usrataqila/microaqilausrat/resources/aqifuseholder.jpeg

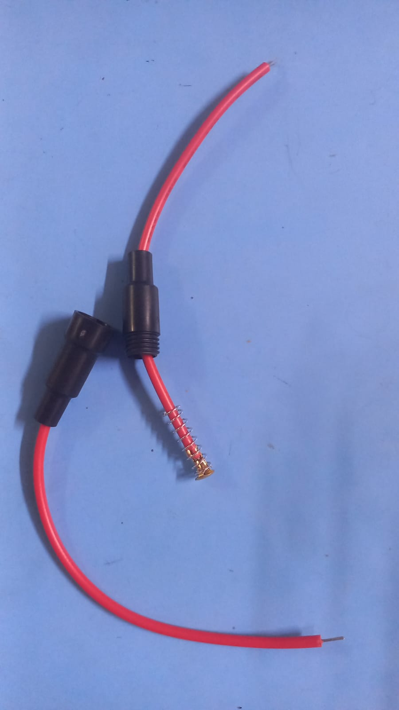
resources/aqifuseholder.jpeg
