usrataqila/microaqilausrat/resources/oled2.jpeg

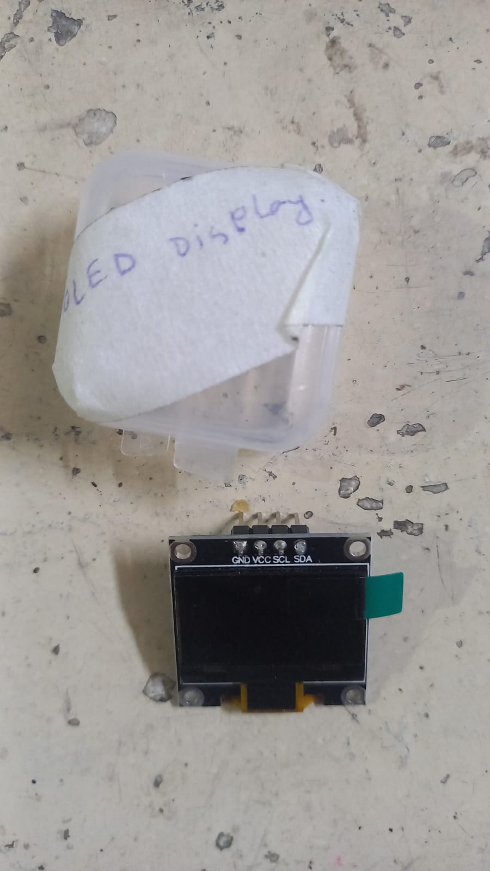
resources/oled2.jpeg
