usrataqila/microaqilausrat/README.md

# microaqilausrat

Project workspace.

> Placeholder README — replace once the project files are added.
