usrataqila/microaqilausrat/resources/adapter.jpeg

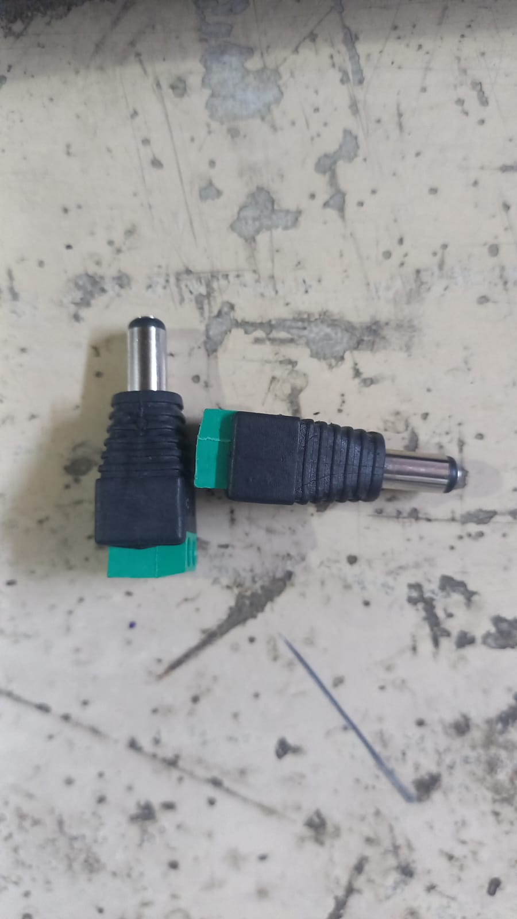
resources/adapter.jpeg
