usrataqila/microaqilausrat/resources/aqiceramicresistor.jpeg

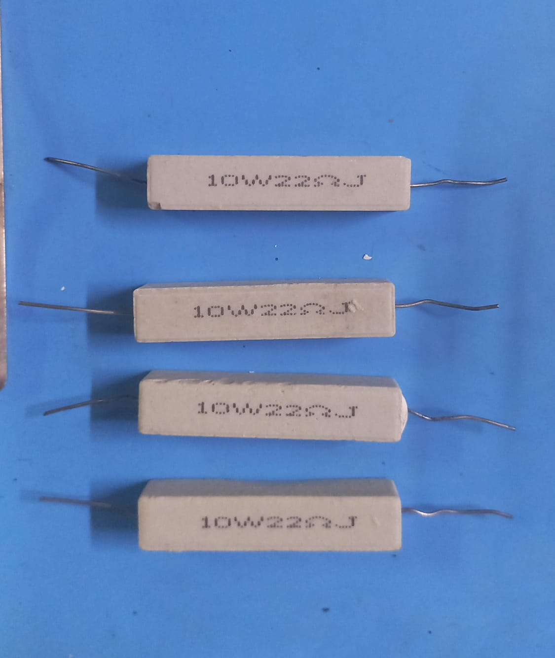
resources/aqiceramicresistor.jpeg
