usrataqila/microaqilausrat/resources/aqifuse.jpeg

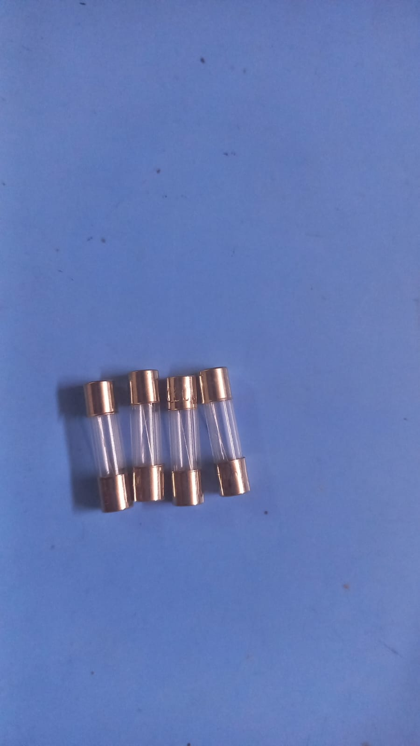
resources/aqifuse.jpeg
