usrataqila/microaqilausrat/resources/aqijackmaleandfemale2.jpeg

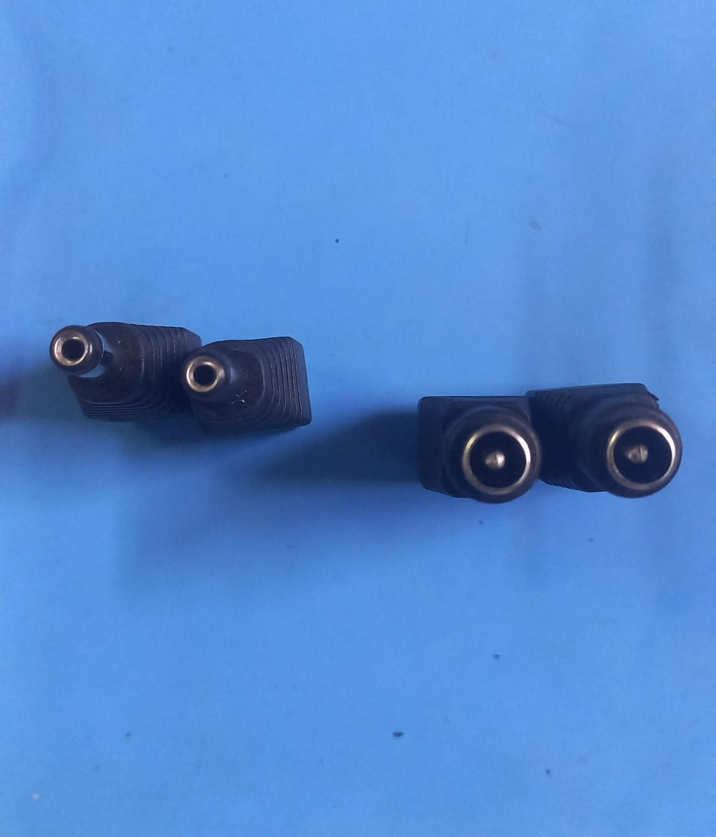
resources/aqijackmaleandfemale2.jpeg
