usrataqila/microaqilausrat/resources/aqijackmaleandfemale.jpeg

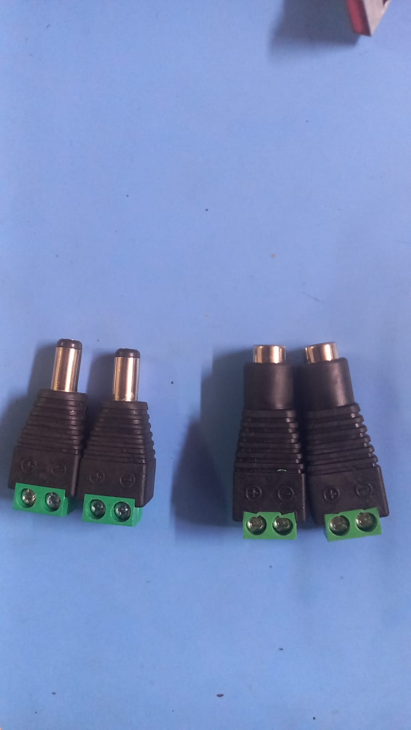
resources/aqijackmaleandfemale.jpeg
