usrataqila/microaqilausrat/resources/aqimultimeter.jpeg

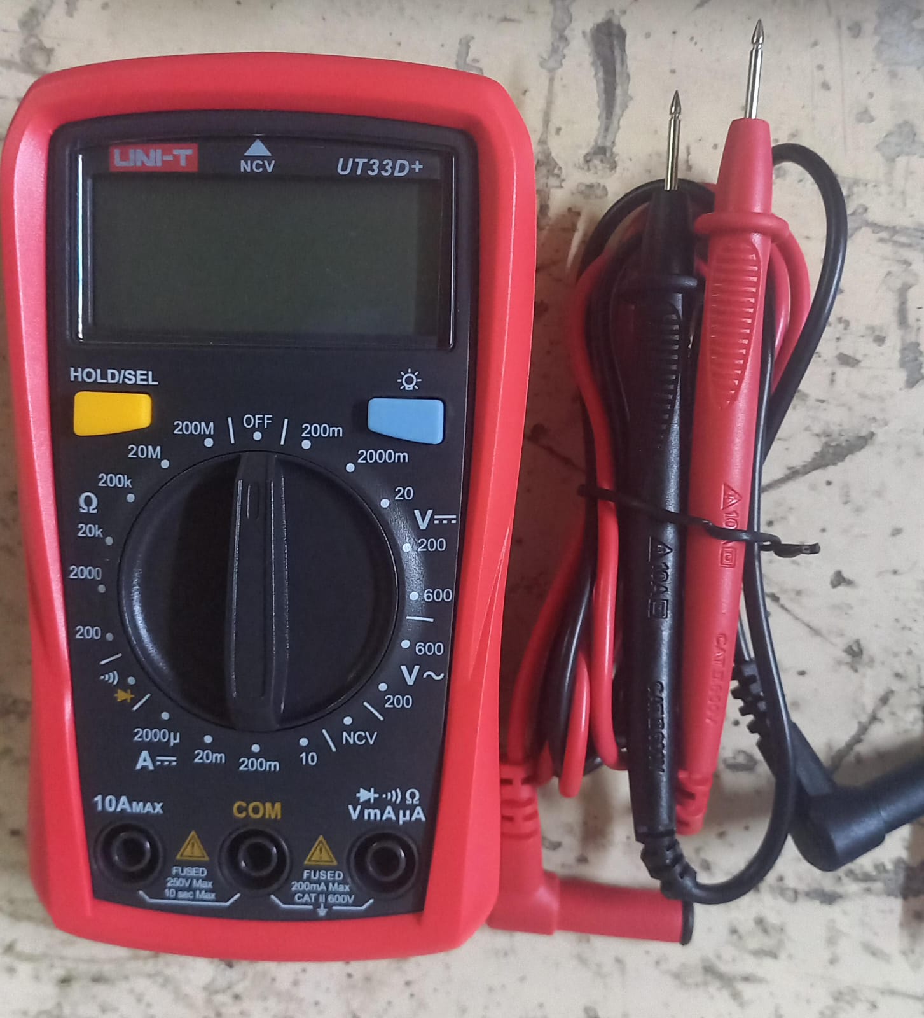
resources/aqimultimeter.jpeg
