usrataqila/microaqilausrat/resources/aqithermalswitch.jpeg

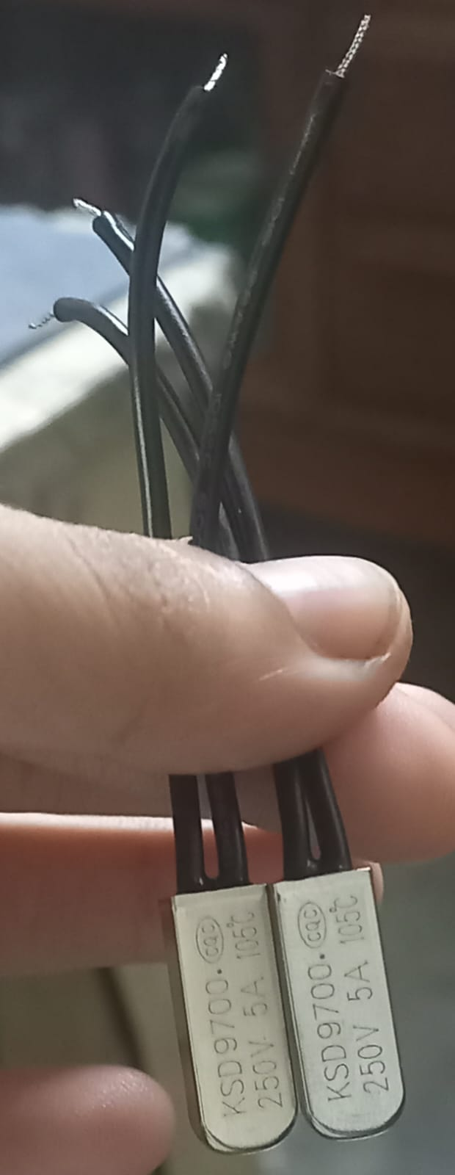
resources/aqithermalswitch.jpeg
