usrataqila/microaqilausrat/resources/aqiwire.jpeg

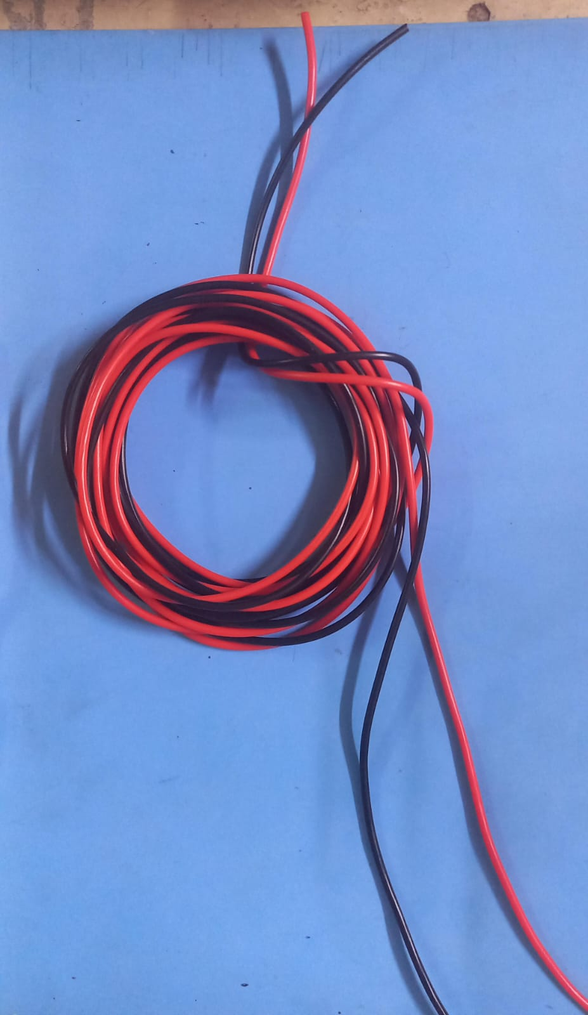
resources/aqiwire.jpeg
