usrataqila/microaqilausrat/resources/breadboard.jpeg

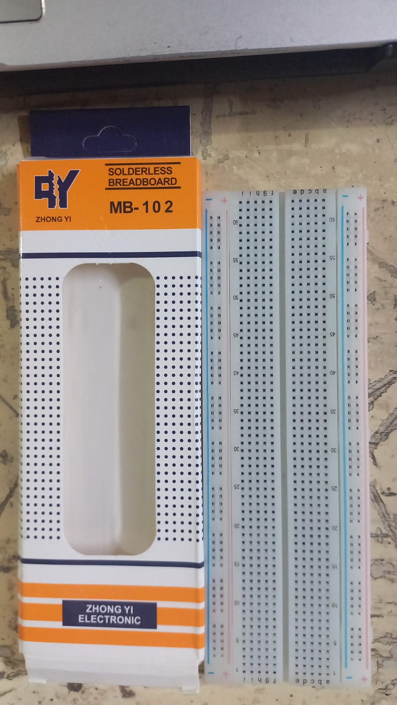
resources/breadboard.jpeg
