usrataqila/microaqilausrat/resources/esp2.jpeg

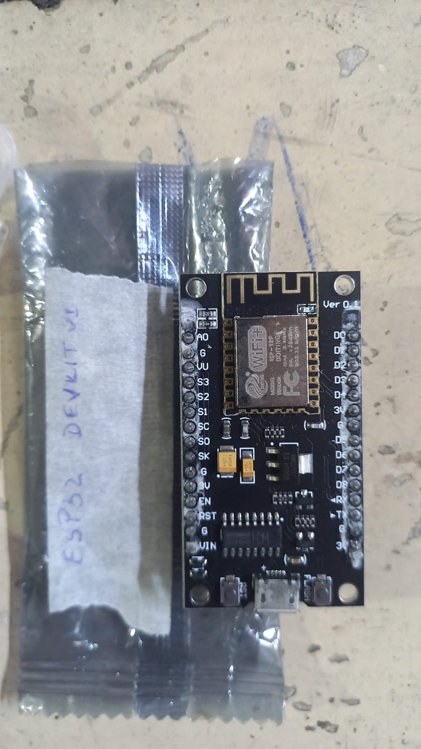
resources/esp2.jpeg
