usrataqila/microaqilausrat/resources/esp.jpeg

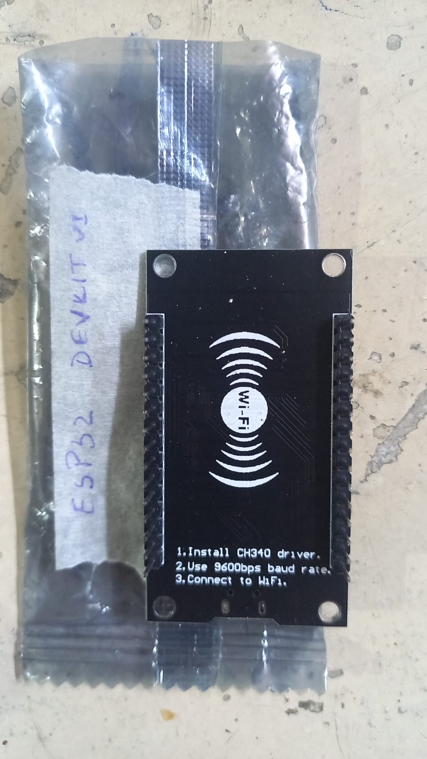
resources/esp.jpeg
