usrataqila/microaqilausrat/resources/fan.jpeg

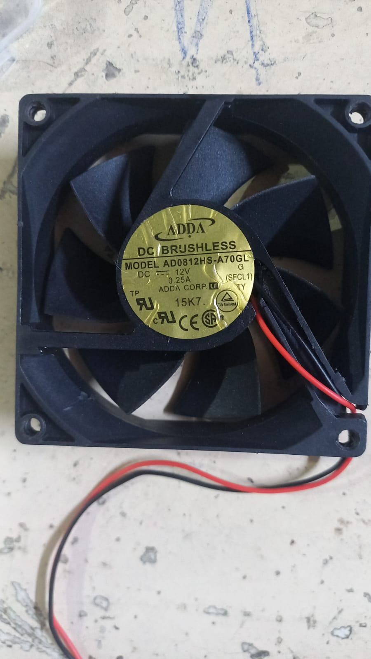
resources/fan.jpeg
