usrataqila/microaqilausrat/resources/handmadeheater.jpeg

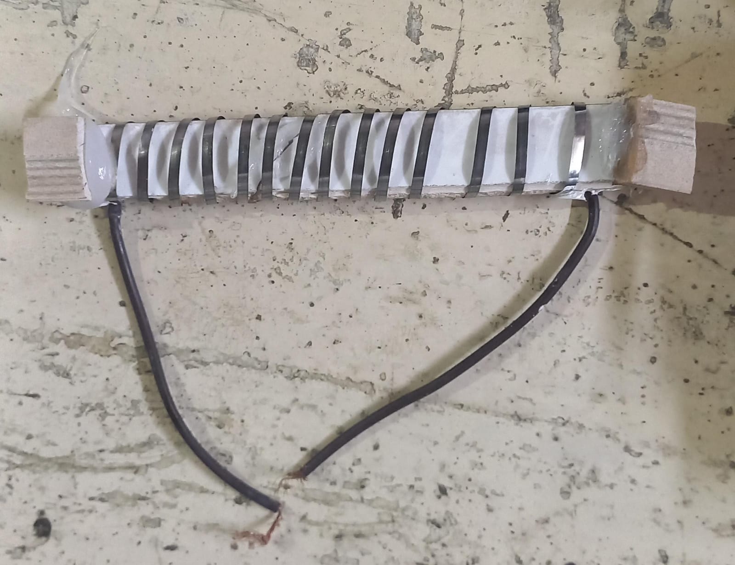
resources/handmadeheater.jpeg
