usrataqila/microaqilausrat/resources/multimeter.jpeg

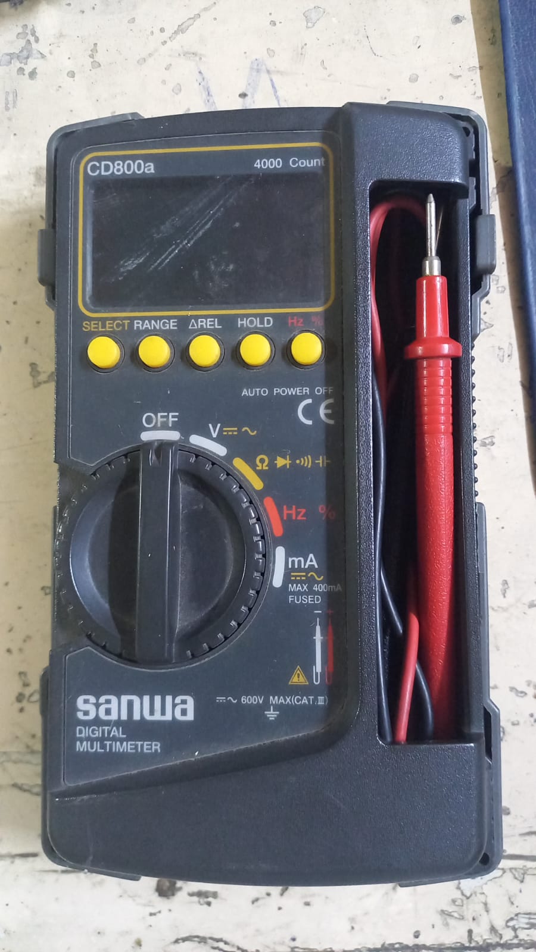
resources/multimeter.jpeg
