usrataqila/microaqilausrat/resources/oled.jpeg

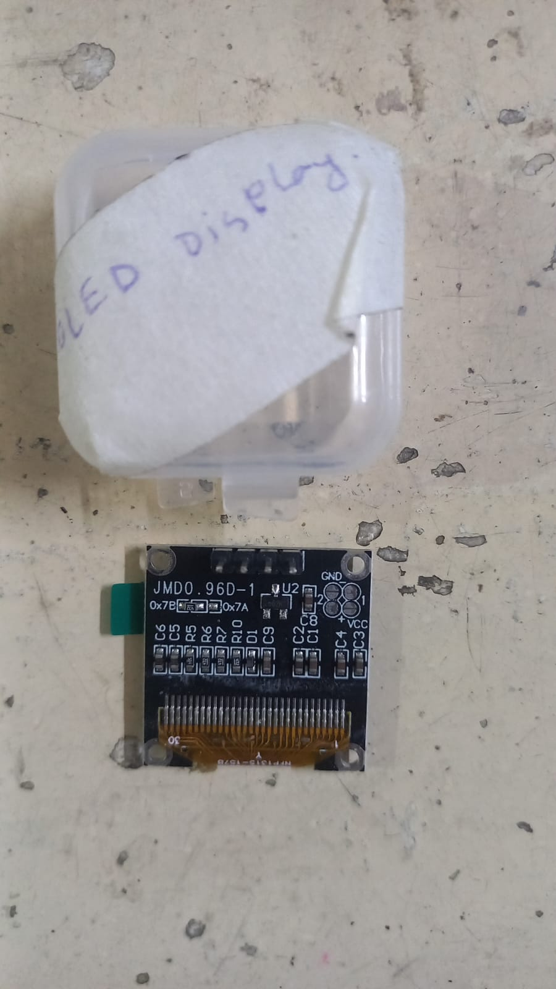
resources/oled.jpeg
