usrataqila/microaqilausrat/resources/powerbrick.jpeg

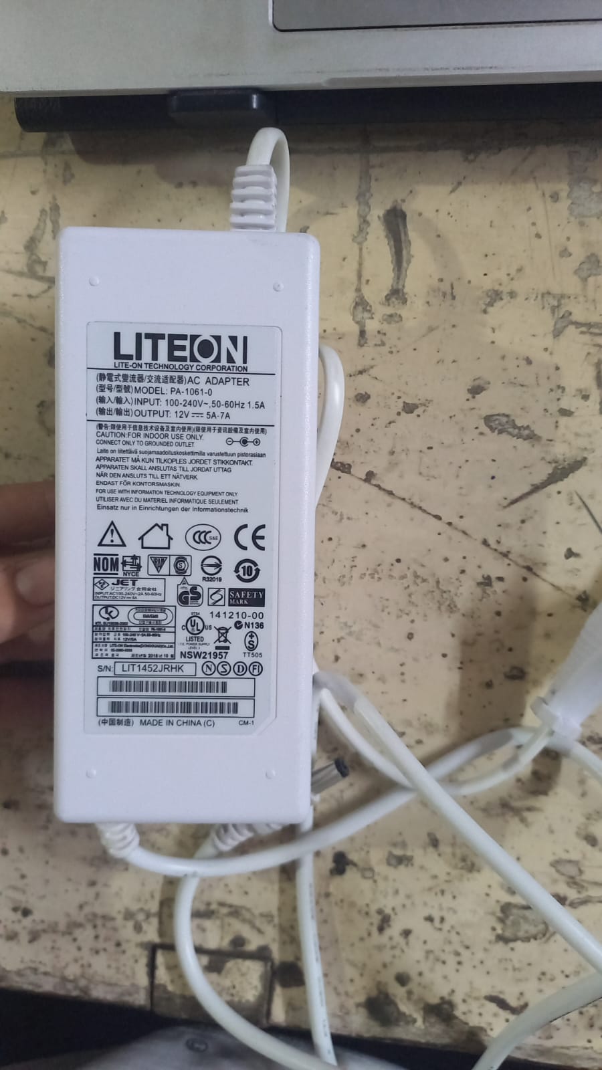
resources/powerbrick.jpeg
