usrataqila/microaqilausrat/resources/relay2.jpeg

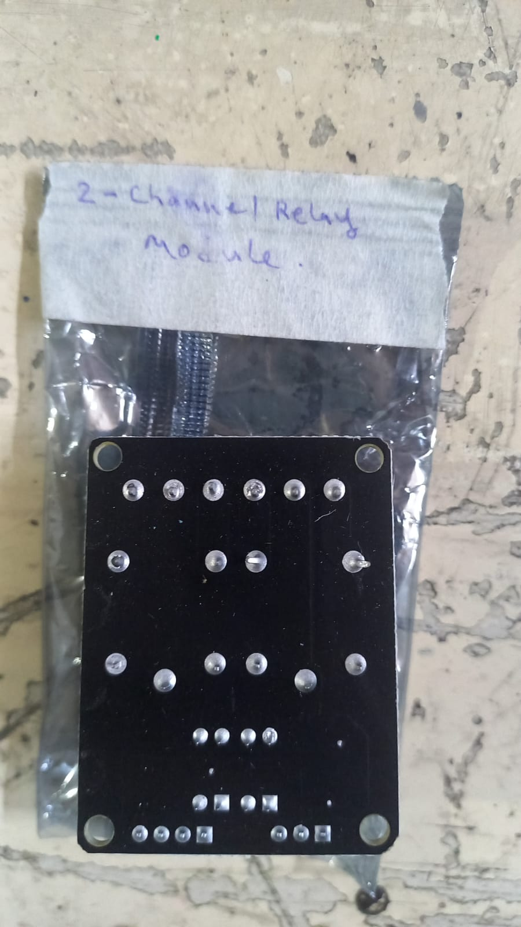
resources/relay2.jpeg
