usrataqila/microaqilausrat/resources/relay.jpeg

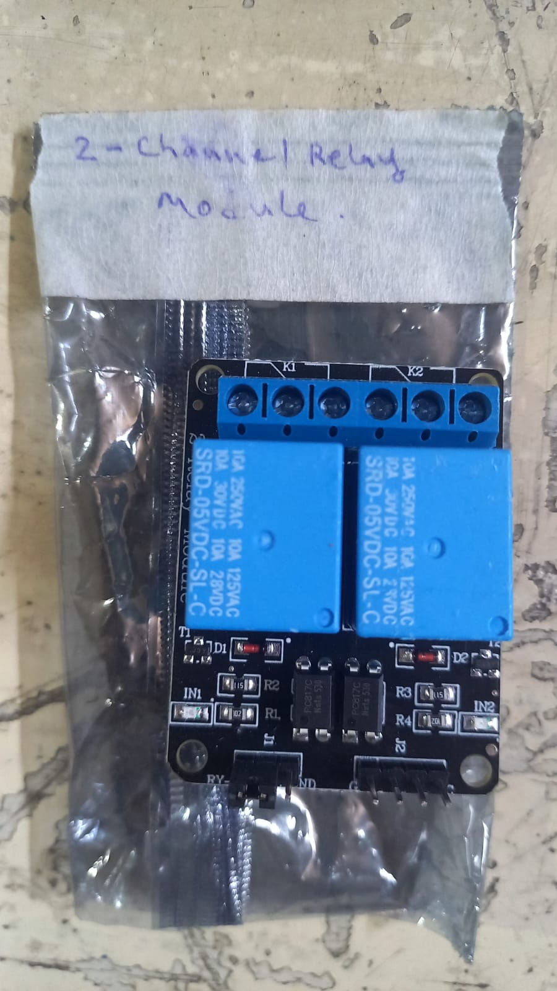
resources/relay.jpeg
