usrataqila/microaqilausrat/resources/tape.jpeg

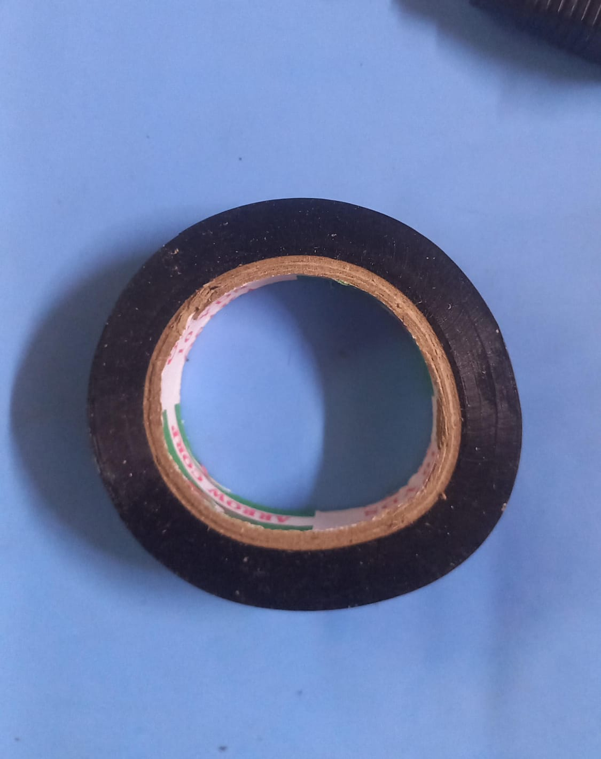
resources/tape.jpeg
