usrataqila/microaqilausrat/resources/temphumid2.jpeg

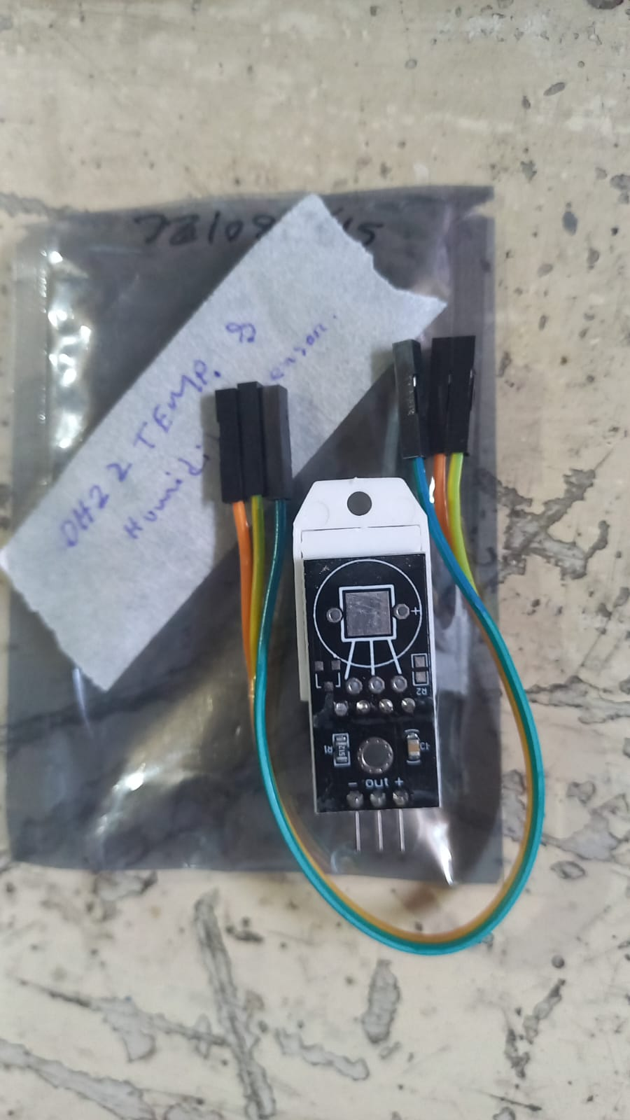
resources/temphumid2.jpeg
