usrataqila/microaqilausrat/resources/temphumid.jpeg

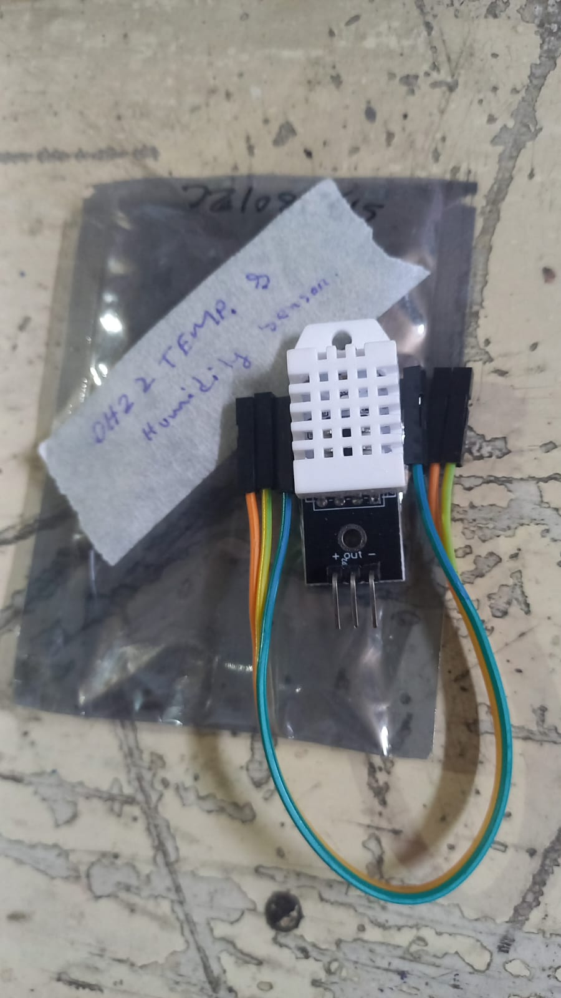
resources/temphumid.jpeg
