usrataqila/microaqilausrat/resources/wires.jpeg

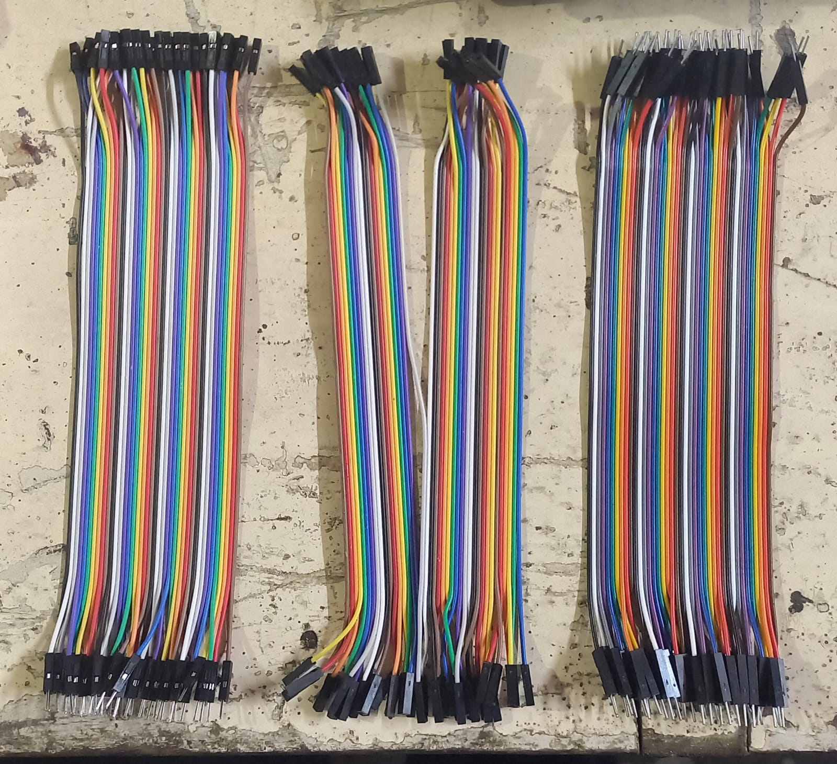
resources/wires.jpeg
