usrataqila/microaqilausrat/docs/PRICE_GUIDE.png

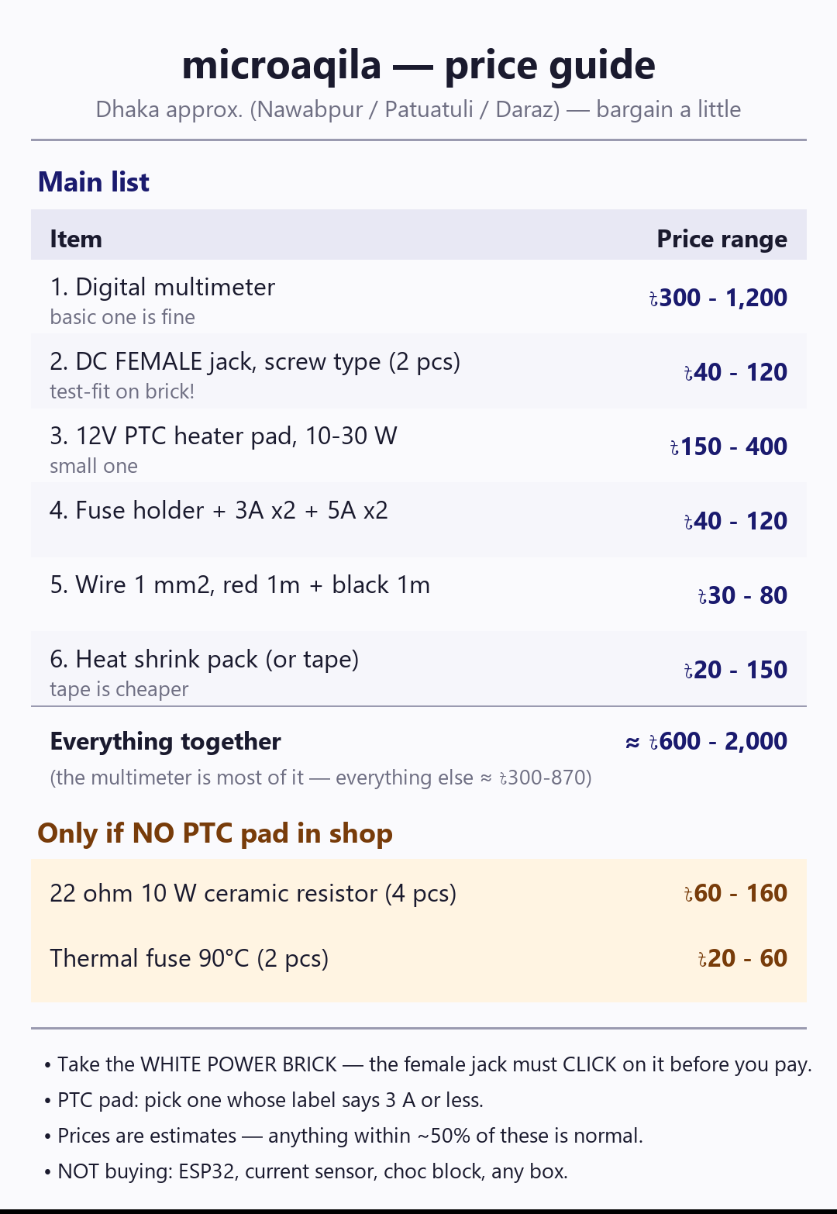
docs/PRICE_GUIDE.png
