usrataqila/microaqilausrat/docs/CIRCUIT_DIAGRAM.pdf

## microaqila — circuit diagram (as built)

## FAN

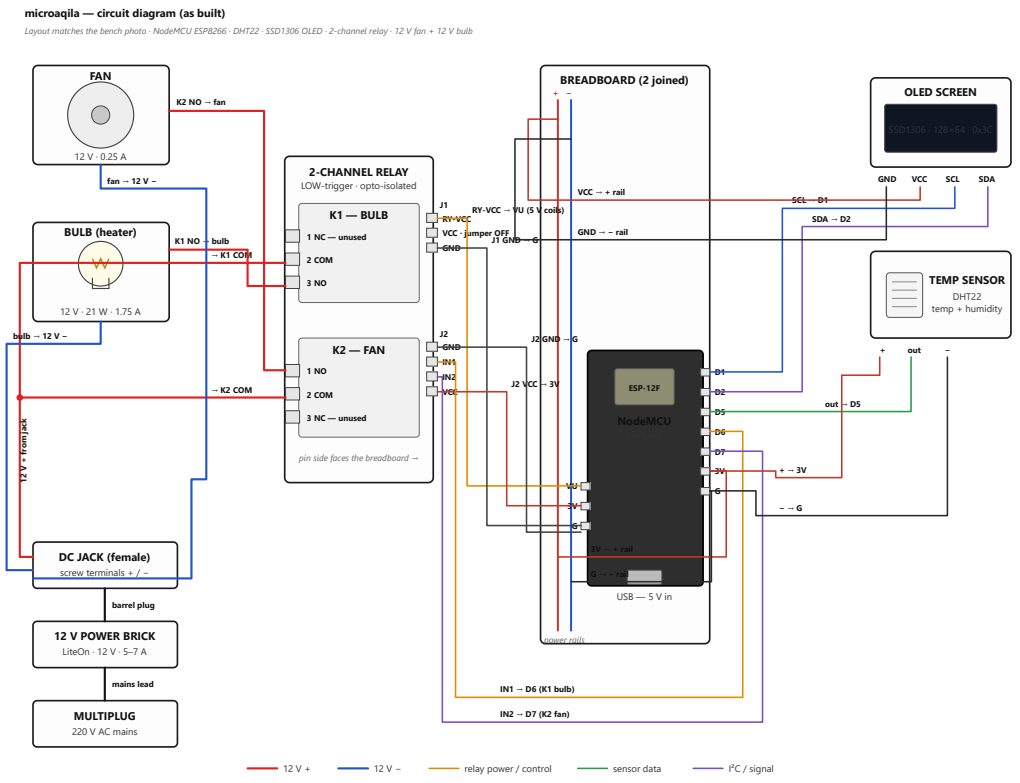
[picture p26: page 1]
BULB (heater); 12 V POWER BRICK LiteOn · 12 V · 5–7 A; MULTIPLUG 220 V AC mains; barrel plug; mains lead; 1 NC — unused; 2 COM; K2 — FAN; 3 NC — unused; J2 GND IN1 IN2 VCC; BREADBOARD (2 joined) + −; power rails; ESP-12F; NodeMCU ESP8266; USB — 5 V in; OLED SCREEN; SSD1306 · 128×64 · 0x3C; GND; VCC; SCL; SDA; TEMP SENSOR DHT22 temp + humidity; out; 12 V + from jack; → K1 COM; → K2 COM; K1 NO → bulb; K2 NO → fan; bulb → 12 V −; fan → 12 V −; J1 GND → G; J2 VCC → 3V; J2 GND → G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

Layout matches the bench photo · NodeMCU ESP8266 · DHT22 · SSD1306 OLED · 2-channel relay · 12 V fan + 12 V bulb

2-CHANNEL RELAY
LOW-trigger · opto-isolated
K1 — BULB

RY-VCC → VU (5 V coils)
RY-VCC
VCC · jumper OFF
GND

pin side faces the breadboard →

DC JACK (female)
screw terminals + / −
