usrataqila/microaqilausrat/(commit log)

2026-08-25 Add proposal, hardware photos, diag firmware, wiring plan and build log
    Board measured as ESP8266EX (NodeMCU) on COM6 despite ESP32 bag label.
    Toolchain: local arduino-cli in tools/ (gitignored), esptool via pip.
2026-08-25 Board bring-up complete: diag_v1 flashed and verified over serial
2026-08-29 Hardware build complete: OLED, DHT22, both relays, fan, heater bank verified
    Covers build sessions 2-5 (2026-08-25 to 2026-08-27), all bench-verified.
    Firmware:
    - diag_v2..v7: OLED render, DHT22 read, relay click test, fan-in-series
    terminal ID, ESP-as-continuity-tester for the screw terminals, and a
    supervised one-shot heater burst test with cold-check and abort logic.
    - control_v1: first closed loop (fan-only thermostat, switch counter).
    - control_v2: adds Wi-Fi AP + embedded web UI on 192.168.4.1.
    - control_v3: heater + fan thermostat, EEPROM-persisted target/gap,
    safety precedence chain (over-temp / sensor-loss / max-on rest),
    HEATER_MAX_ON_MS tightened to 3 min.
    Docs:
    - BUILD_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
    [config.h, control_v1.ino, control_v2.ino, control_v3.ino, diag_v2.ino, diag_v3.ino, diag_v4.ino, diag_v5.ino]
2026-08-29 control_v4: adaptive threshold band, fixed/adaptive modes, run logger
    The objective the project title is named after.
    Adaptive rule (firmware/control_v4/control_v4.ino, adapt()): every 60 s,
    count relay switches since the last review. 4 or more widens the hysteresis
    band by 0.1 C; exactly 0 while both relays are idle tightens it by 0.1 C.
    Clamped to 0.2-2.0 C. That is the whole algorithm.
    - Base vs live band split: cfg.gap is the user's saved starting band,
    gap is the live one adaptation moves. FIXED snaps back to cfg.gap so it
    is a genuine control condition, and it still counts each window so both
    modes are measured identically.
    - Web UI gains ADAPTIVE/FIXED buttons, a live band rea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
    [config.h, control_v4.ino, run_log.py]
2026-08-29 Deep scan of senior samples: their block diagram proves no hysteresis
    Extracted every embedded image from both source files.
    Their slide 6 block diagram is a flowchart with single-point comparisons
    (Temp < 25? / Temp > 30?) - heater on and off happen at the SAME temperature.
    That is the mechanism behind the limitation they admit on slide 9, so we now
    have cause and effect from one source.
    Also recorded: their simulation uses NodeMCU V3 (ESP8266), their heater is a
    mains incandescent bulb on RL2, their light is a second bulb on RL1, they used
    a 4-channel relay module, their app is Blynk-style with min/max thresholds, and
    all three figures in their report are stock catalogue photos rather th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
2026-08-29 control_v5: plain threshold thermostat on the user's decision
    The user asked for the seniors' control logic instead of the adaptive band,
    matching their slide 6 flowchart exactly:
    if (temp < minC) heater ON, fan OFF
    else if (temp > maxC) heater OFF, fan ON
    else both OFF
    Two user-set thresholds, no hysteresis, no adaptation. minC/maxC are edited
    from the ESP's own web page and saved to EEPROM (magic bumped to 0xA9C3).
    Removed vs control_v4: adaptive band, ADAPTIVE/FIXED buttons, RESET COUNTERS,
    live-band readout, run timer, /api/reset.
    Kept: the ESP's own Wi-Fi AP and web UI, OLED, EEPROM persistence, and the
    full safety chain (45 C abort, sensor-loss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
    [config.h, control_v5.ino]
2026-08-31 Add as-built circuit diagram (SVG)
    Layout follows the bench photo: fan and bulb on the left, relay module with
    its pin side facing the breadboard, NodeMCU on the joined breadboards, OLED
    and DHT22 on the right, and the 12 V chain running jack -> brick -> multiplug.
    Shows all six relay control wires (J1 split supply with the jumper removed),
    the I2C and DHT connections by pin, and which screw each 12 V load lands on:
    K1 screws 2+3 for the bulb, K2 screws 1+2 for the fan, middle screw = COM.
    Notes panel records that the 3 A fuse and 105 C thermal cutout are currently
    removed and must be refitted before the bulb is run.
2026-08-31 Add interactive wiring map (clickable HTML)
    Replaces the cluttered static SVG approach: no permanent wire labels at all.
    Click any wire (or any row in the connection list) and every other wire dims
    while the inspector shows from / to / what it carries, plus why it is wired
    that way.
    Layout corrected to the real bench: the ESP and OLED are drawn plugged INTO
    the breadboard rather than floating beside it, the relay's pin side faces the
    board, and the USB data cable to the laptop is included.
    24 connections covered across six groups: display (I2C), sensor, relay
    control, rails, 12 V power, power in. Keyboard accessible, Escape clears,
    light and dark themes.
    Static SVG kept at docs/CIRCUIT_DI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
2026-08-31 Label components in plain terms: TEMP SENSOR, OLED SCREEN
    Part numbers move to the sub-label. Applied to both the interactive wiring
    map and the static circuit diagram.
2026-08-31 Add circuit diagram as PDF
    Single page, 1420x1000 pt, vector (text stays selectable and sharp at any
    zoom). Generated from docs/CIRCUIT_DIAGRAM.svg.
2026-08-31 Drop the notes panel from the circuit diagram and regenerate the PDF
2026-08-31 control_v5 final: abort at 40 C, Project G7 branding, section comments
    - ABORT_TEMP_C lowered 45.0 -> 40.0 on the user's call.
    - Web page title and heading are now "Project G7" (the AP stays micro1),
    and the serial banner matches.
    - Every section of both files now carries a comment block explaining what
    that section does and why it is written that way - intended to be read
    and defended, not skimmed.
    - New USER_MIN_LIMIT_C / USER_MAX_LIMIT_C (15-38 C) bound what the web
    page will accept. The upper bound sits below the 40 C abort ceiling on
    purpose: previously a user could set a fan threshold of 44 C, which the
    safety cut-out would always beat to it and which would read as a fault.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
